chris-derman03/MGC/Connection Diagram.jpg

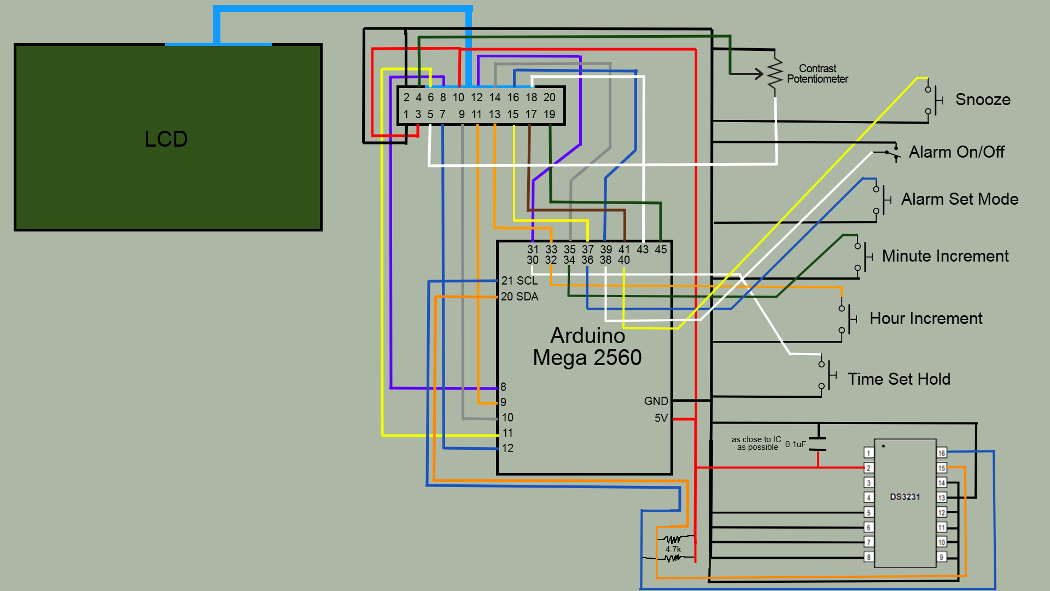
Connection Diagram.jpg
