chris-derman03/MGC/PIN CONNECTIONS.png

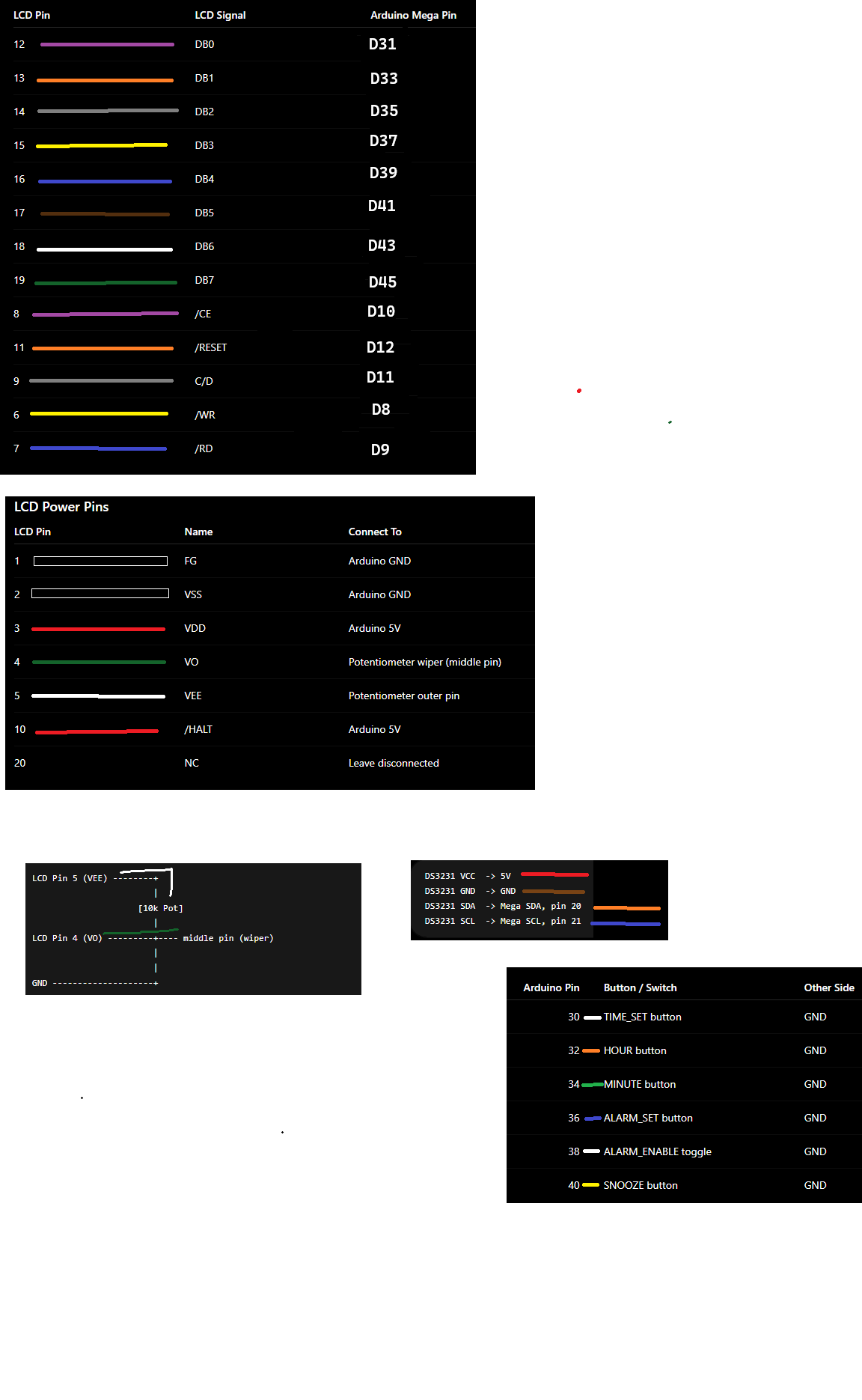
PIN CONNECTIONS.png
