chris-derman03/MGC/RA6963-N1/bitmaps/_resources/number (0).png

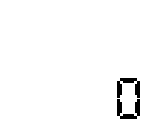
RA6963-N1/bitmaps/_resources/number (0).png
