chris-derman03/MGC/RA6963-N1/bitmaps/_resources/number (8)-2.png

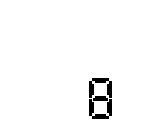
RA6963-N1/bitmaps/_resources/number (8)-2.png
