chris-derman03/MGC/RA6963-N1/bitmaps/_resources/screen_base.jpg

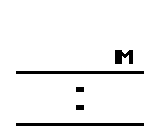
RA6963-N1/bitmaps/_resources/screen_base.jpg
