chris-derman03/MGC/CAD/mgc/mgc.kicad_pcb

## KiCad design CAD/mgc/mgc.kicad_pcb (2026-07-04)

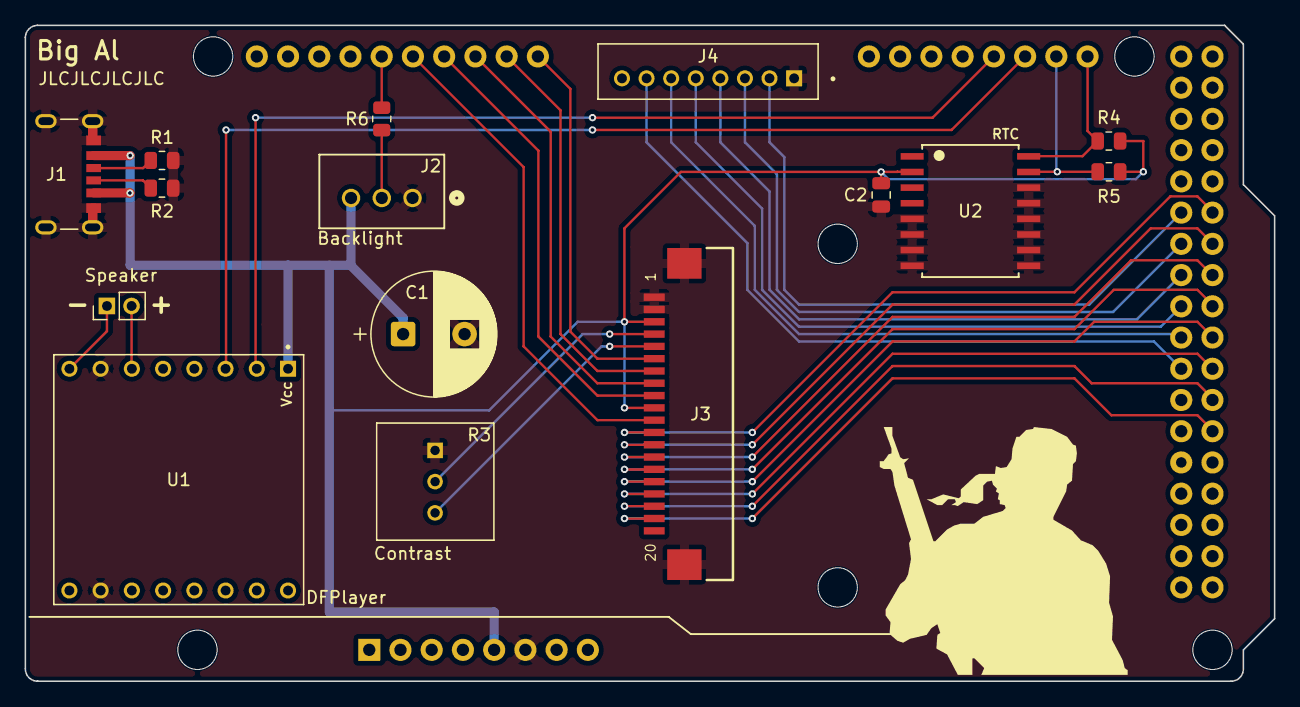
[picture p8: board mgc.kicad_pcb from above]

Board: 2 copper layers, 101.6 x 53.3 mm, 16 parts (0 on the bottom side), 33 nets.

Parts:
A1: A000067; MODULE_A000067
C1: 1000u; CP_Radial_D10.0mm_P5.00mm
C2: 0.1uF; C_0805_2012Metric
J1: 10164359-00011LF; AMPHENOL_10164359-00011LF
J2: B3B-XH-A; CONN_B3B-XH-A_JST
J3: FFC3B07-20-T; GCT_FFC3B07-20-T
J4: B8B-PH-K-S; JST_B8B-PH-K-S
LS1: Speaker; PinHeader_1x02_P2.00mm_Vertical
R1, R2: 5.1k; R_0805_2012Metric
R3: Potentiometer; TRIM_COM-09806
R4, R5: 4.7k; R_0805_2012Metric
R6: 330; R_0805_2012Metric
U1: DFR0299; MODULE_DFR0299
U2: ds3231sn-; 21-0042B_16_MXM

Connections:
+5V: A1.5V_1 (+5V_1), C1.1, C2.2, J1.A9 (VBUS_A), J1.B9 (VBUS_B), J2.3, J3.3, J3.10, R4.1, R5.1, U1.1 (VCC), U2.2 (VCC)
/30 (TIME_SET): A1.30, J4.2
/31 (LCD_D0): A1.31, J3.12
/32 (HOUR++): A1.32, J4.3
/33 (LCD_D1): A1.33, J3.13
/34 (MINUTE++): A1.34, J4.4
/35 (LCD_D2): A1.35, J3.14
/36 (ALARM_SET): A1.36, J4.5
/37 (LCD_D3): A1.37, J3.15
/38 (ALARM_TOGGLE): A1.38, J4.6
/39 (LCD_D4): A1.39, J3.16
/40 (SNOOZE): A1.40, J4.7
/41 (LCD_D5): A1.41, J3.17
/43 (LCD_D6): A1.43, J3.18
/45 (LCD_D7): A1.45, J3.19
/*8 (LCD_WR): A1.8, J3.6
/*9 (LCD_RD): A1.9, J3.7
/*10 (LCD_CE): A1.10, J3.8
/*11 (LCD_C/D): A1.11, J3.9
/*12 (LCD_RESET): A1.12, J3.11
/*13 (Backlight): A1.13, R6.1
/Contrast Output: J3.5, R3.3
/Contrast Wiper: J3.4, R3.2
/RX1/19: A1.19, U1.3 (TX)
/SCL/21: A1.21, R4.2, U2.16 (SCL)
/SDA/20: A1.20, R5.2, U2.15 (SDA)
/TX1/18: A1.18, U1.2 (RX)
GND: A1.GND1, C1.2, C2.1, J1.A12 (GND_A), J1.B12 (GND_B), J1.SH1 (SHIELD), J1.SH2 (SHIELD__1), J1.SH3 (SHIELD__2), J1.SH4 (SHIELD__3), J2.1, J3.1, J3.2, J3.S1 (SHIELD), J3.S2 (SHIELD), J4.1, R1.1, R2.2, R3.1, U1.7 (GND), U1.10 (GND__1), U2.5 (NC), U2.6 (NC), U2.7 (NC), U2.8 (NC), U2.9 (NC), U2.10 (NC), U2.11 (NC), U2.12 (NC), U2.13 (GND), U2.14 (VBAT)
unnamed: J1.A5 (CC1), R1.2
unnamed: J1.B5 (CC2), R2.1
unnamed: J2.2, R6.2
unnamed: LS1.2, U1.6 (SPK1)
unnamed: LS1.1, U1.8 (SPK2)
