chris-derman03/MGC/RA6963-N1/display_config.h

#pragma once

#define SCREEN_WIDTH         160
#define SCREEN_HEIGHT        128
#define SCREEN_BYTES         ((SCREEN_WIDTH * SCREEN_HEIGHT) / 8)
#define SCREEN_BYTES_PER_ROW (SCREEN_WIDTH / 8) 
